Maks027/LabPS/bom.xlsx

Nr. | Name | Package | Quantity | Price
1 | GBJ2510 | GBJ | 1 | 12 | 12
2 | SMA4007 | SMA | 20 | 0.3 | 6
3 | ES3G | SMC | 2 | 3 | 6
 |  |  |  |  | 0
4 | 2SC5200 | 2-21F1A | 1 | 23 | 23
5 | BD140 | TO-126 | 2 | 3 | 6
6 | MMBT5551 | SOT-23 | 10 | 0.6 | 6
 |  |  |  |  | 0
7 | TL431AIDBZR | SOT-23 | 1 | 4 | 4
8 | L7812ABV | TO-220 | 1 | 5 | 5
 |  |  |  |  | 0
9 | 510K | 1206 | 10 | 0.2 | 2
10 | 100K | 1206 | 10 | 0.2 | 2
11 | 39K | 1206 | 10 | 0.2 | 2
12 | 20K | 1206 | 10 | 0.2 | 2
13 | 10K | 1206 | 30 | 0.1 | 3
14 | 9,1K | 1206 | 10 | 0.2 | 2
15 | 4,7K | 1206 | 10 | 0.2 | 2
16 | 2,7K | 1206 | 10 | 0.2 | 2
17 | 2K | 1206 | 10 | 0.2 | 2
18 | 1K | 1206 | 30 | 0.1 | 3
19 | 4,3K | 1W | 2 | 0.5 | 1
20 | 5,6K | 1W | 2 | 0.5 | 1
21 | 0,1R | 2W | 2 | 1 | 2
22 | 0,15R | 2W | 2 | 1 | 2
 |  |  |  |  | 0
23 | 3300uF, 63V | 18х40 | 2 | 18 | 36
24 | 330uF, 16V | 6,3x11 | 4 | 1 | 4
25 | 10uF, 63V | 5x11 | 2 | 0.4 | 0.8
26 | 1uF, 63V | CL21X mini | 3 | 2 | 6
27 | 0,56uF, 63V | CL21 | 2 | 1 | 2
28 | 1nF | 1206 | 10 | 0.3 | 3
29 | 10nF | 1206 | 10 | 0.3 | 3
30 | 100nF | 1206 | 10 | 0.3 | 3
31 | 1uF | 1206 | 10 | 0.5 | 5
 |  |  |  |  | 0
32 | DG306-5,08-03 |  | 2 | 3 | 6
33 | 2K | 3323P | 2 | 4 | 8
 |  |  |  |  | 172.8
