Maks027/LabPS/Schematic_uControl.pdf

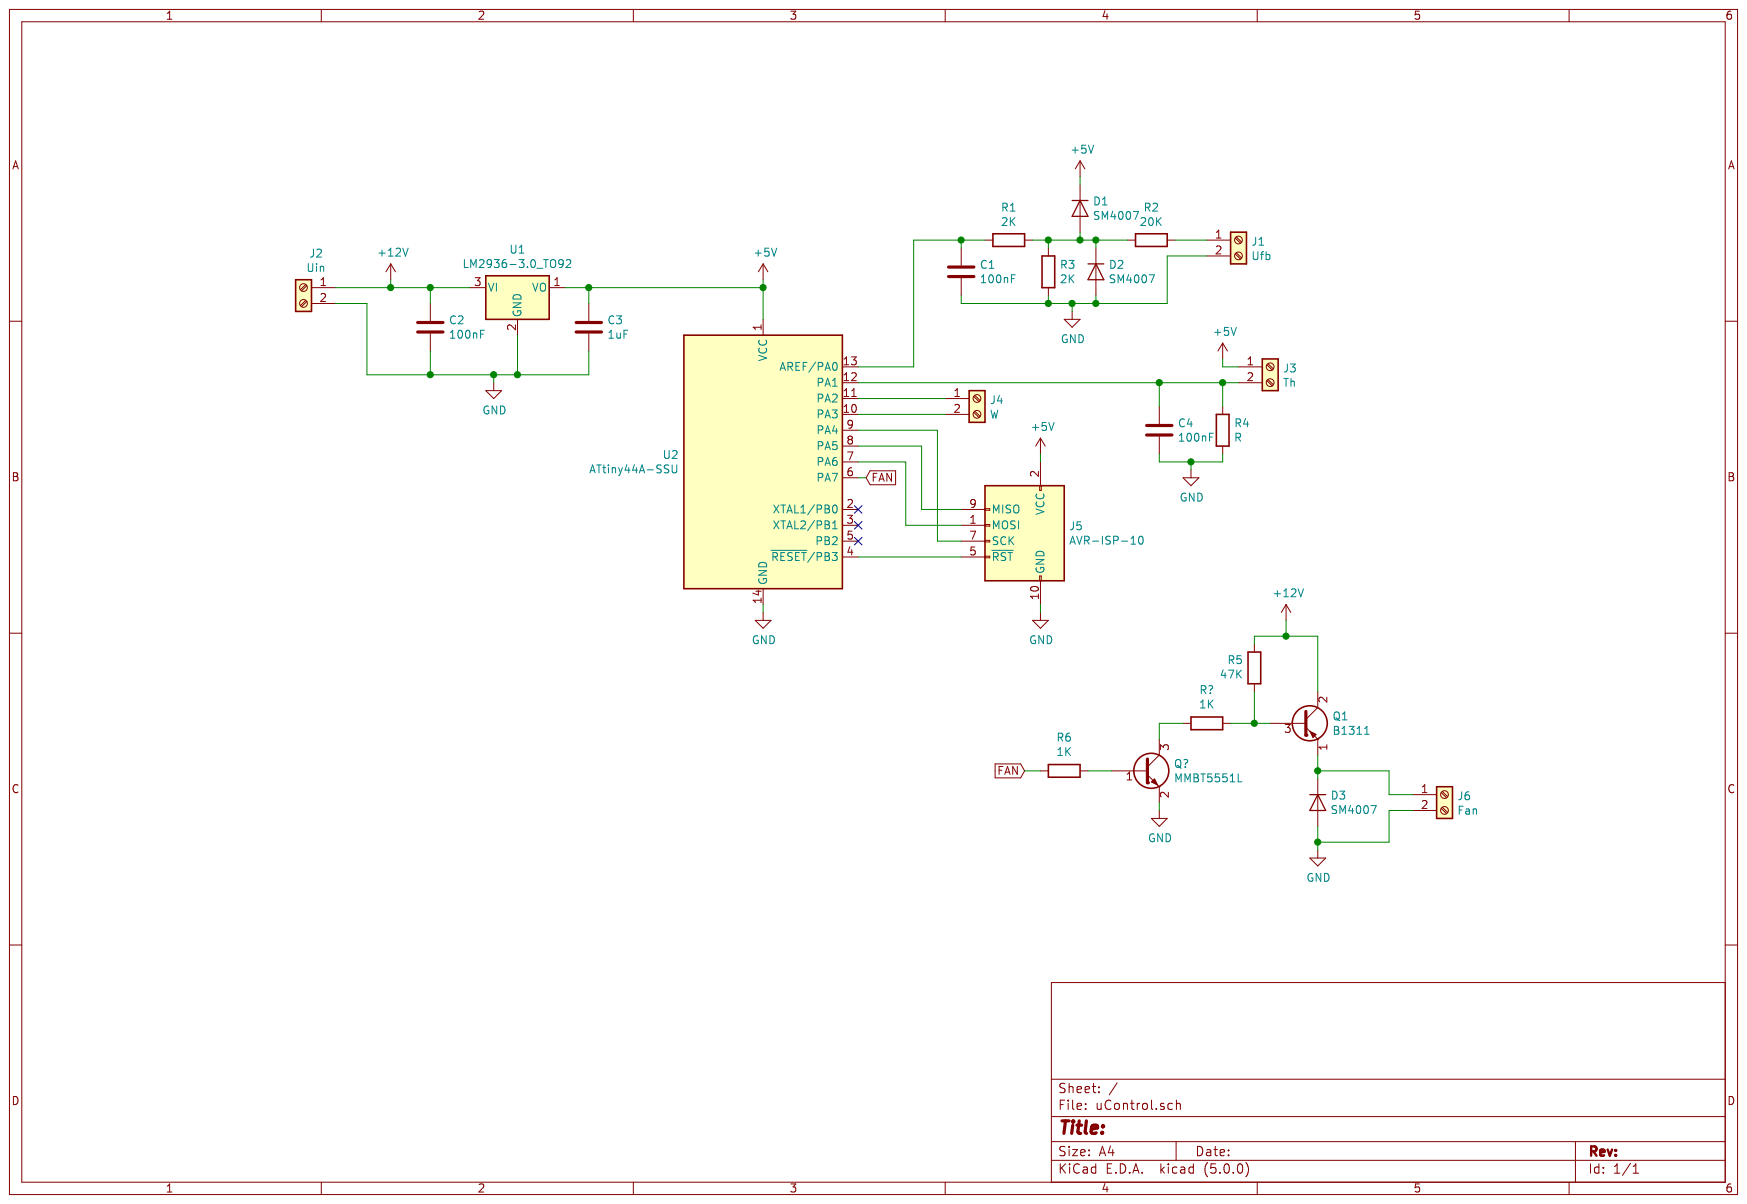
[picture p1: page 1]
