Maks027/LabPS/Schematic_Regulator.pdf

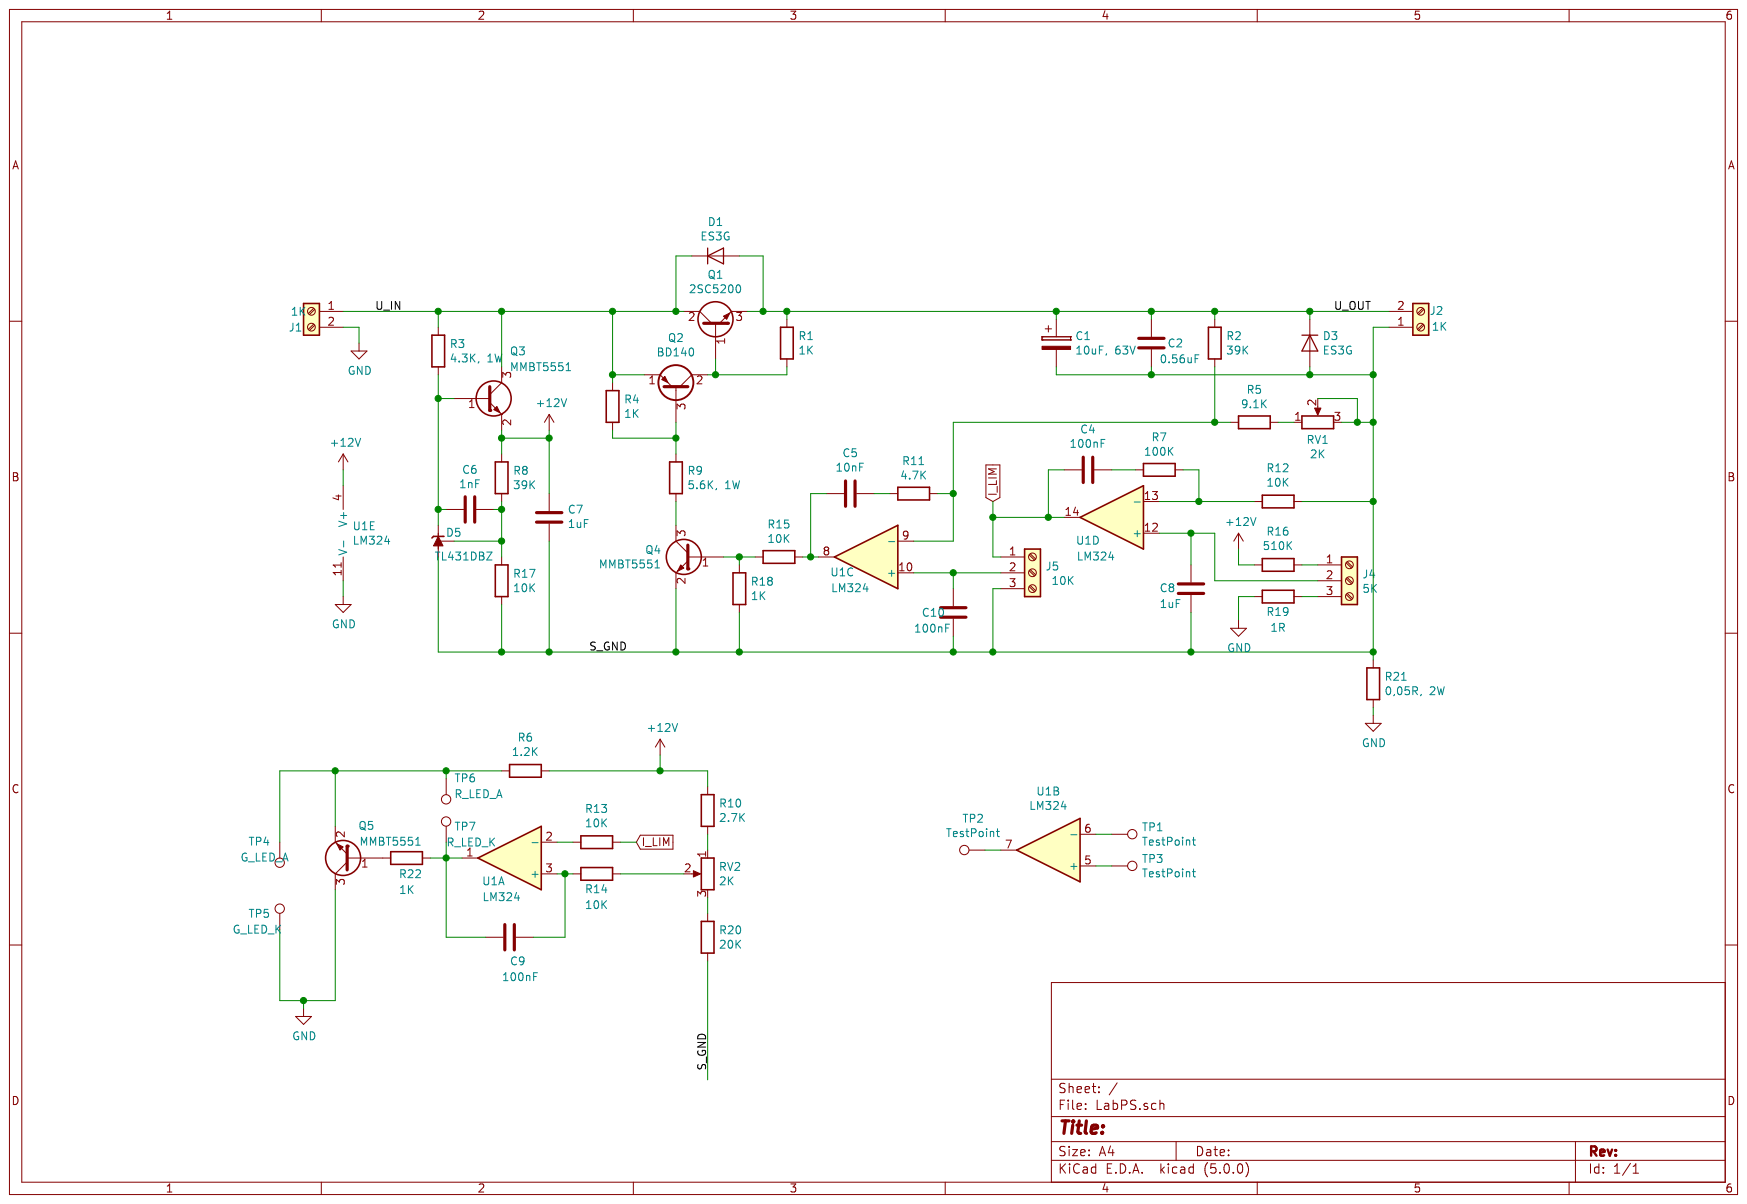
[picture p2: page 1]
