Maks027/LabPS/Schematic_Windings_Commutator.pdf

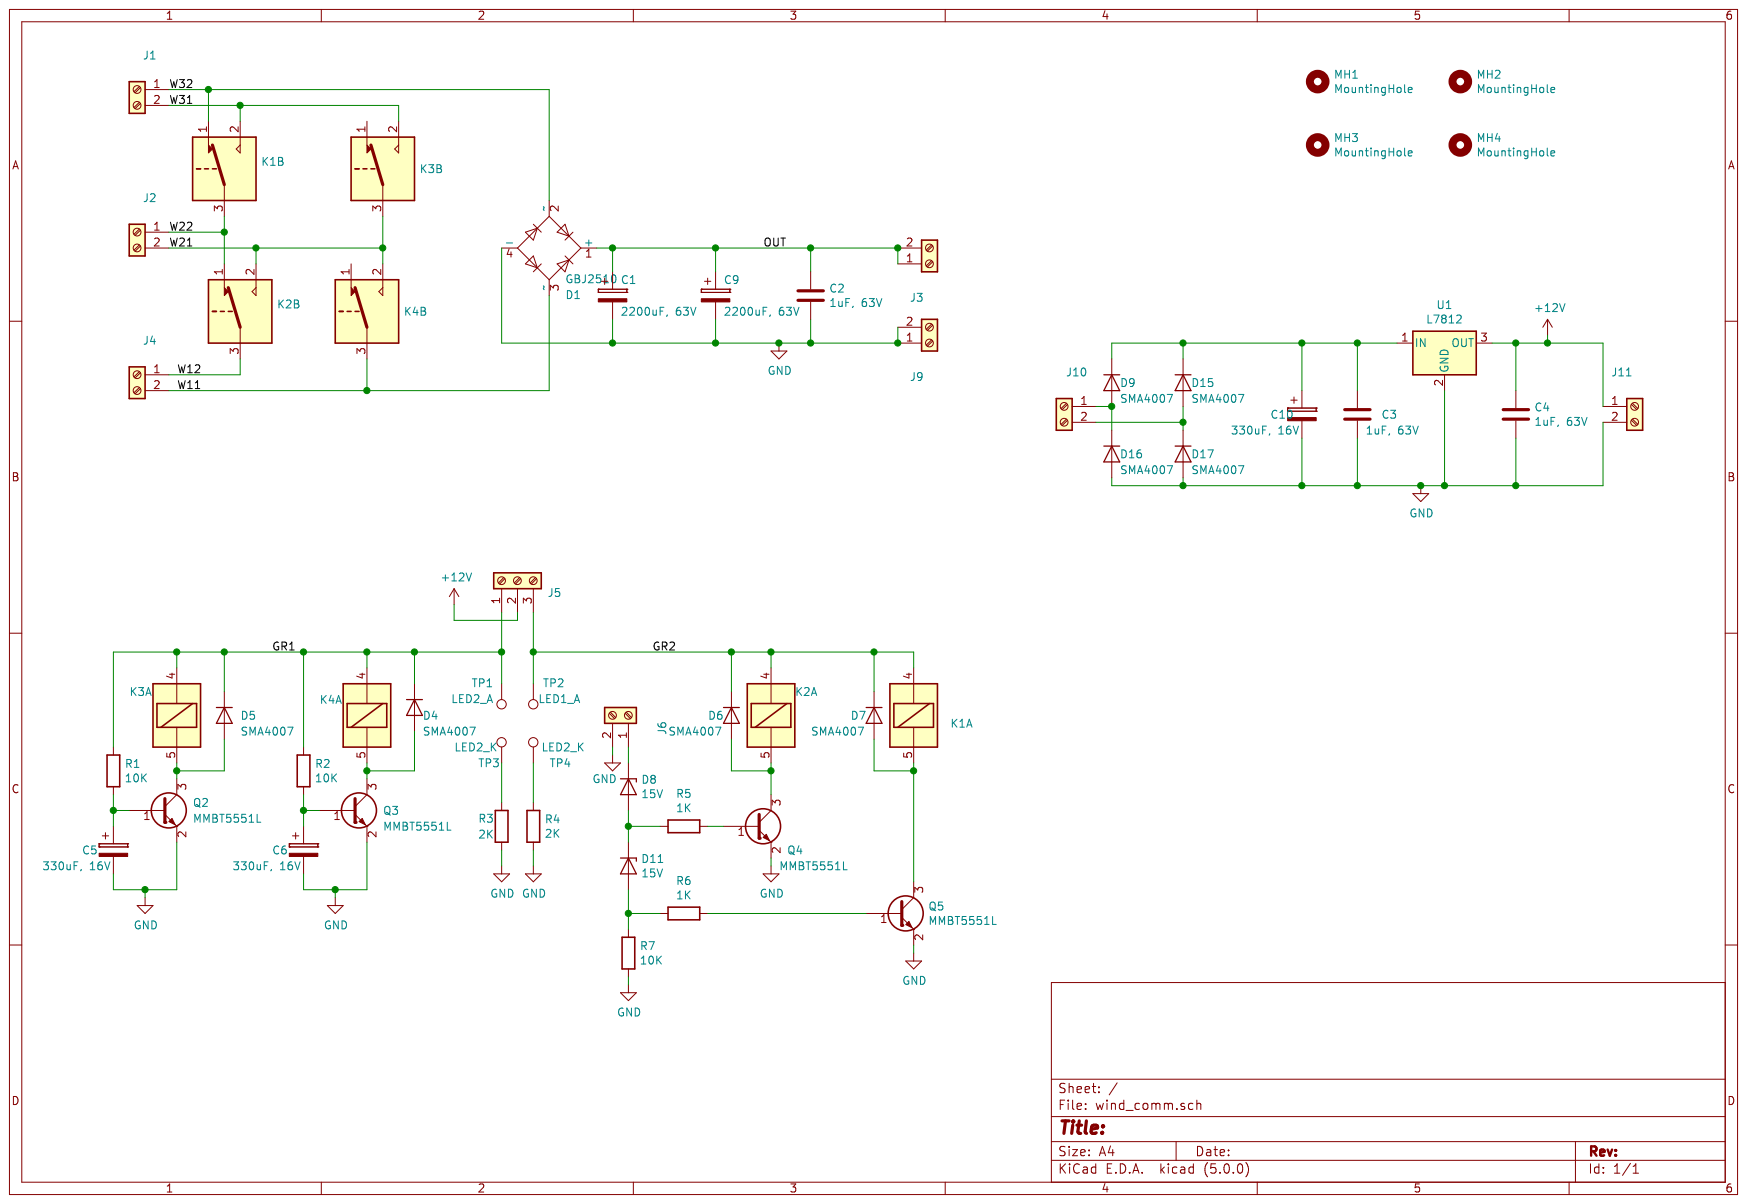
[picture p3: page 1]
