Maks027/LabPS/KiCAD/LabPS/pcb.pdf

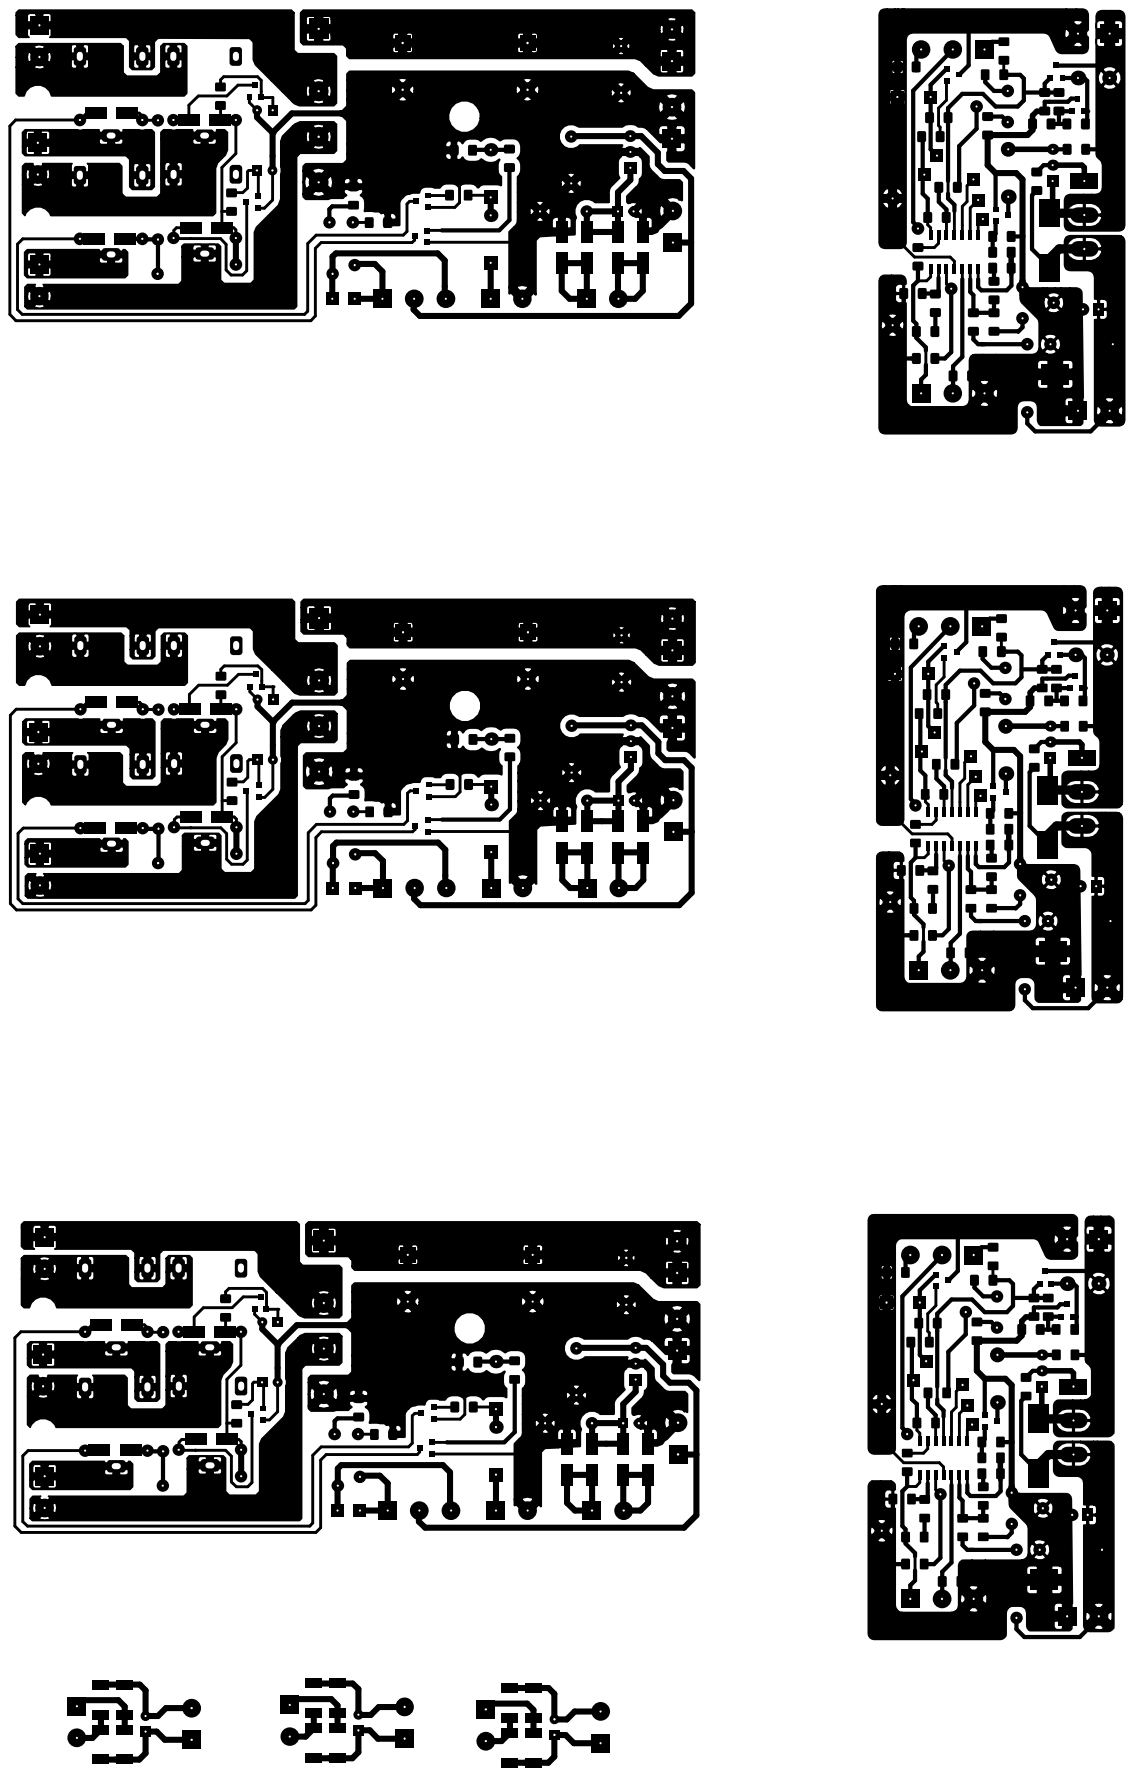
[picture p4: page 1]
