Maks027/LabPS/(list of files, drawings)

Other design files:
KiCAD/wind_comm/wind_comm.dsn
Multisim/LabPS.ms14
