Maks027/LabPS/KiCAD/wind_comm/wind_comm.kicad_pcb

## KiCad design KiCAD/wind_comm/wind_comm.kicad_pcb (2020-04-28)

Schematic: wind_comm.sch

Parts:
C1, C9: 2200uF, 63V; CP_Radial_D18.0mm_P7.50mm
C2, C4: 1uF, 63V; C_Rect_L10.3mm_W7.2mm_P7.50mm_MKS4
C3: 1uF, 63V; C_Rect_L10.3mm_W5.0mm_P7.50mm_MKS4
C5, C6, C10: 330uF, 16V; CP_Radial_D6.3mm_P2.50mm
D1: GBJ2510; Diode_Bridge_Vishay_GBJ
D4, D5, D6, D7, D9, D15, D16, D17: SMA4007; D_SMA_Handsoldering
D8, D11: 15V; D_DO-41_SOD81_P7.62mm_Horizontal
J1, J10: Winding 3; TerminalBlock_bornier-2_P5.08mm
J2: Winding 2; TerminalBlock_bornier-2_P5.08mm
J3: OUT_V; TerminalBlock_bornier-2_P5.08mm
J4: Winding 1; TerminalBlock_bornier-2_P5.08mm
J5: Switch Connector; TerminalBlock_bornier-3_P5.08mm
J6: Volatge Feedback; TerminalBlock_bornier-2_P5.08mm
J9: OUT_GND; TerminalBlock_bornier-2_P5.08mm
J11: 12V_OUT; TerminalBlock_bornier-2_P5.08mm
K1, K2, K3, K4: SRA-12VDC-CL
MH1, MH2, MH3, MH4: MountingHole; MountingHole_3.2mm_M3_ISO7380
Q2, Q3, Q4, Q5: MMBT5551L; SOT-23
R1, R2, R7: 10K; R_1206_3216Metric_Pad1.42x1.75mm_HandSolder
R3, R4: 2K; R_1206_3216Metric_Pad1.42x1.75mm_HandSolder
R5, R6: 1K; R_1206_3216Metric_Pad1.42x1.75mm_HandSolder
TP1: LED2_A; TestPoint_THTPad_2.0x2.0mm_Drill1.0mm
TP2: LED1_A; TestPoint_THTPad_2.0x2.0mm_Drill1.0mm
TP3, TP4: LED2_K; TestPoint_THTPad_D2.0mm_Drill1.0mm
U1: L7812; TO-220-3_Vertical

Connections:
+12V: C4.1, J5.2, J11.1, U1.3 (OUT)
/GR1: D4.1, D5.1, J5.1, K3.4, K4.4, R1.1, R2.1, TP1.1
/GR2: D6.1, D7.1, J5.3, K1.4, K2.4, TP2.1
/OUT: C1.1, C2.1, C9.1, D1.1 (+), J3.1, J3.2
/W11: D1.3 (~~), J4.2, K4.3
/W12: J4.1, K2.3
/W21: J2.2, K2.2, K3.3, K4.2
/W22: J2.1, K1.3, K2.1
/W31: J1.2, K1.2, K3.2
/W32: D1.2 (~~), J1.1, K1.1
GND: C1.2, C2.2, C3.2, C4.2, C5.2, C6.2, C9.2, C10.2, D1.4 (-), D16.2, D17.2, J6.2, J9.1, J9.2, J11.2, Q2.2 (E), Q3.2 (E), Q4.2 (E), Q5.2 (E), R3.2, R4.2, R7.2, U1.2 (GND)
unnamed: C5.1, Q2.1 (B), R1.2
unnamed: C6.1, Q3.1 (B), R2.2
unnamed: C3.1, C10.1, D9.1, D15.1, U1.1 (IN)
unnamed: D4.2, K4.5, Q3.3 (C)
unnamed: D5.2, K3.5, Q2.3 (C)
unnamed: D6.2, K2.5, Q4.3 (C)
unnamed: D7.2, K1.5, Q5.3 (C)
unnamed: D8.1, J6.1
unnamed: D8.2, D11.1, R5.2
unnamed: D11.2, R6.2, R7.1
unnamed: D15.2, D17.1, J10.2
unnamed: D9.2, D16.1, J10.1
unnamed: Q4.1 (B), R5.1
unnamed: Q5.1 (B), R6.1
unnamed: R3.1, TP3.1
unnamed: R4.1, TP4.1

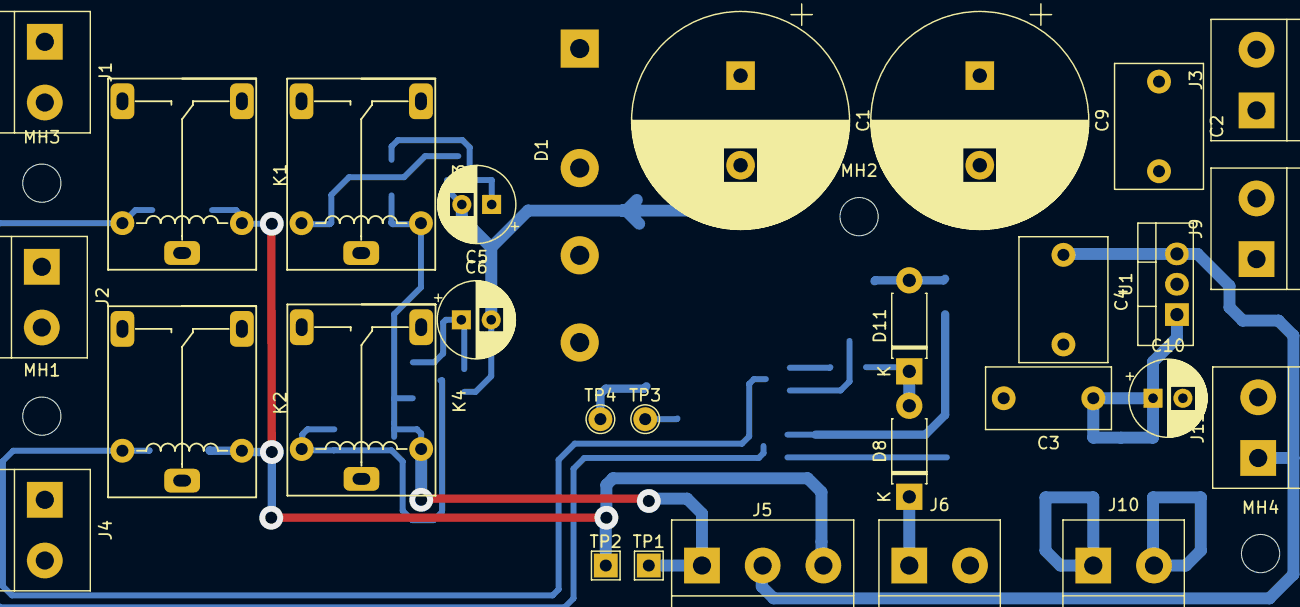
[picture p5: board wind_comm.kicad_pcb from above]

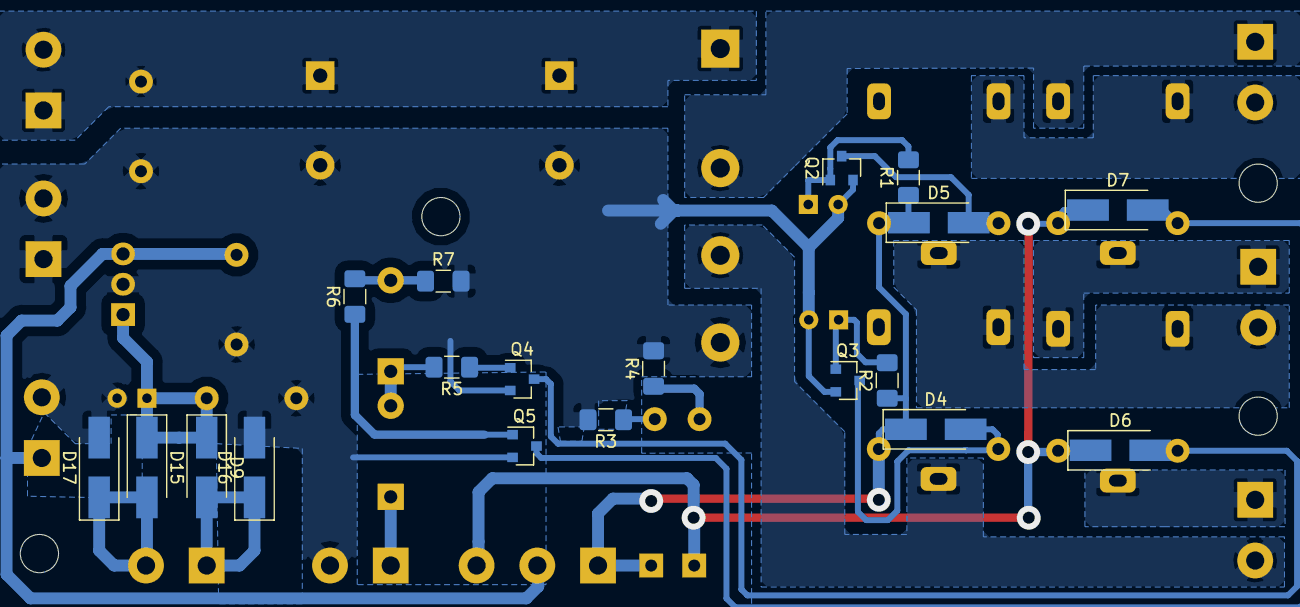
[picture p6: board wind_comm.kicad_pcb from below]

Board: 2 copper layers, 52 parts (19 on the bottom side), 27 nets.
