Maks027/LabPS/KiCAD/LabPS/LabPS/LabPS.kicad_pcb

## KiCad design KiCAD/LabPS/LabPS/LabPS.kicad_pcb (2020-04-28)

Schematic: LabPS.sch

Parts:
C1: 10uF, 63V; CP_Radial_D5.0mm_P2.50mm
C2: 0.56uF; C_Rect_L13.0mm_W5.0mm_P10.00mm_FKS3_FKP3_MKS4
C4, C9, C10: 100nF; C_1206_3216Metric_Pad1.42x1.75mm_HandSolder
C5: 10nF; C_1206_3216Metric_Pad1.42x1.75mm_HandSolder
C6: 1nF; C_1206_3216Metric_Pad1.42x1.75mm_HandSolder
C7, C8: 1uF; C_1206_3216Metric_Pad1.42x1.75mm_HandSolder
D1, D3: ES3G; D_SMC_Handsoldering
D5: TL431DBZ; SOT-23
J1, J2: 1K; TerminalBlock_bornier-2_P5.08mm
J4: 5K; TerminalBlock_bornier-3_P5.08mm
J5: 10K; TerminalBlock_bornier-3_P5.08mm
Q1: 2SC5200; TO-3P-3_Vertical
Q2: BD140; TO-126-3_Vertical
Q3, Q4, Q5: MMBT5551; SOT-23
R1, R4, R18, R22: 1K; R_1206_3216Metric_Pad1.42x1.75mm_HandSolder
R2, R8: 39K; R_1206_3216Metric_Pad1.42x1.75mm_HandSolder
R3: 4.3K, 1W; R_Axial_DIN0414_L11.9mm_D4.5mm_P5.08mm_Vertical
R5: 9.1K; R_1206_3216Metric_Pad1.42x1.75mm_HandSolder
R6: 1.2K; R_1206_3216Metric_Pad1.42x1.75mm_HandSolder
R7: 100K; R_1206_3216Metric_Pad1.42x1.75mm_HandSolder
R9: 5.6K, 1W; R_Axial_DIN0414_L11.9mm_D4.5mm_P7.62mm_Vertical
R10: 2.7K; R_1206_3216Metric_Pad1.42x1.75mm_HandSolder
R11: 4.7K; R_1206_3216Metric_Pad1.42x1.75mm_HandSolder
R12, R13, R14, R15, R17: 10K; R_1206_3216Metric_Pad1.42x1.75mm_HandSolder
R16: 510K; R_1206_3216Metric_Pad1.42x1.75mm_HandSolder
R19: 1R; R_1206_3216Metric_Pad1.42x1.75mm_HandSolder
R20: 20K; R_1206_3216Metric_Pad1.42x1.75mm_HandSolder
R21: 0,05R, 2W; R_Axial_DIN0516_L15.5mm_D5.0mm_P20.32mm_Horizontal
RV1, RV2: 2K; Potentiometer_Piher_PT-6-V_Vertical
TP1, TP2, TP3: TestPoint; TestPoint_THTPad_2.0x2.0mm_Drill1.0mm
TP4: G_LED_A; TestPoint_THTPad_2.0x2.0mm_Drill1.0mm
TP5: G_LED_K; TestPoint_THTPad_2.0x2.0mm_Drill1.0mm
TP6: R_LED_A; TestPoint_THTPad_2.0x2.0mm_Drill1.0mm
TP7: R_LED_K; TestPoint_THTPad_2.0x2.0mm_Drill1.0mm
U1: LM324

Connections:
+12V: C7.2, Q3.2 (E), R6.2, R8.1, R10.1, R16.1, U1.4 (V+)
/S_GND: C1.2, C2.2, C7.1, C8.1, C10.2, D3.2, D5.3, J2.1, J5.3, Q4.2 (E), R12.2, R17.2, R18.2, R20.2, R21.1, RV1.2, RV1.3
/U_IN: D1.1, J1.1, Q1.2, Q2.1, Q3.3 (C), R3.1, R4.1
/U_OUT: C1.1, C2.1, D1.2, D3.1, J2.2, Q1.3, R1.1, R2.1
GND: J1.2, Q5.3 (C), R19.1, R21.2, TP5.1, U1.11 (V-)
I_LIM: C4.1, J5.1, R13.2, U1.14
unnamed: C4.2, R7.2
unnamed: C5.1, R15.1, U1.8
unnamed: C5.2, R11.2
unnamed: C6.1, D5.2, R8.2, R17.1
unnamed: C6.2, D5.1, Q3.1 (B), R3.2
unnamed: C8.2, J4.2, U1.12 (+)
unnamed: C9.1, R14.1, U1.3 (+)
unnamed: C9.2, R22.1, TP7.1, U1.1
unnamed: C10.1, J5.2, U1.10 (+)
unnamed: J4.1, R16.2
unnamed: J4.3, R19.2
unnamed: Q1.1, Q2.2, R1.2
unnamed: Q2.3, R4.2, R9.1
unnamed: Q4.1 (B), R15.2, R18.1
unnamed: Q4.3 (C), R9.2
unnamed: Q5.1 (B), R22.2
unnamed: Q5.2 (E), R6.1, TP4.1, TP6.1
unnamed: R5.1, RV1.1
unnamed: R10.2, RV2.1
unnamed: R2.2, R5.2, R11.1, U1.9 (-)
unnamed: R7.1, R12.1, U1.13 (-)
unnamed: R13.1, U1.2 (-)
unnamed: R14.2, RV2.2
unnamed: R20.1, RV2.3
unnamed: TP1.1, U1.6 (-)
unnamed: TP2.1, U1.7
unnamed: TP3.1, U1.5 (+)

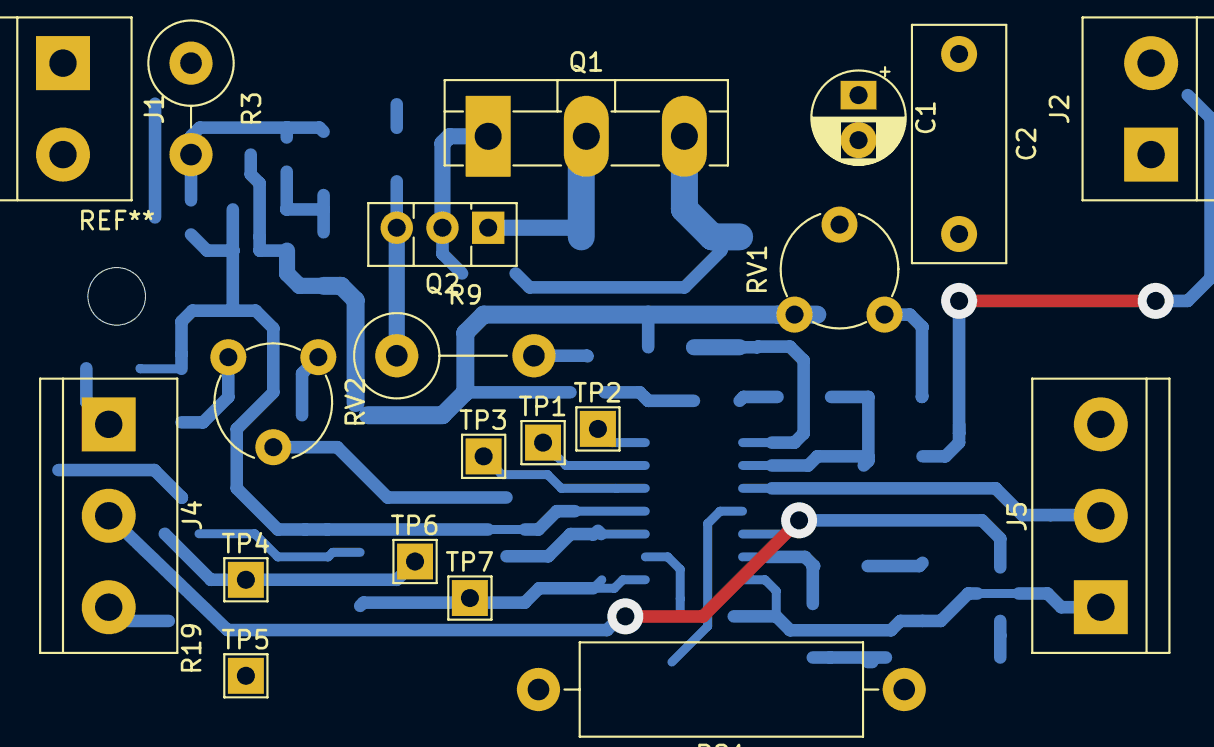
[picture p7: board LabPS.kicad_pcb from above]

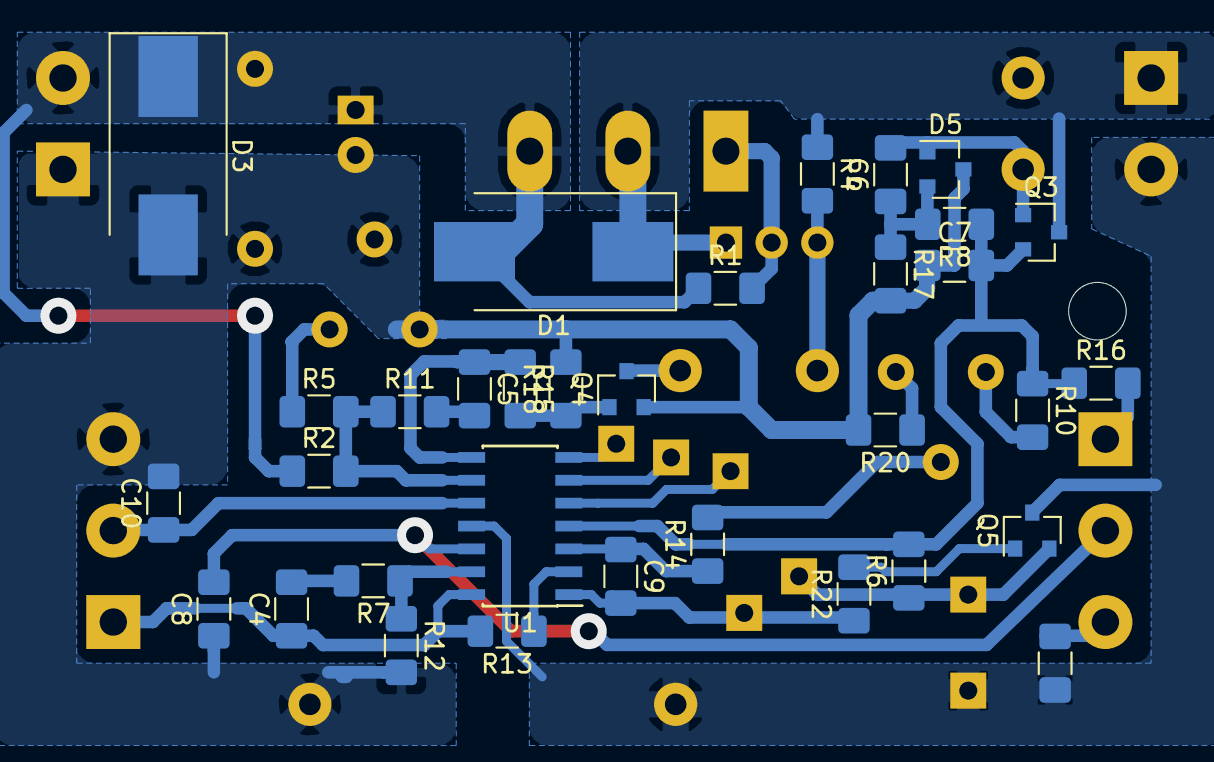
[picture p8: board LabPS.kicad_pcb from below]

Board: 2 copper layers, 53 parts (33 on the bottom side), 33 nets.
