Maks027/LabPS/KiCAD/rectifier/rectifier/rectifier.kicad_pcb

## KiCad design KiCAD/rectifier/rectifier/rectifier.kicad_pcb (2020-04-28)

Schematic: rectifier.sch

Parts:
C1: 330uF, 16V; CP_Radial_D6.3mm_P2.50mm
D1, D2, D3, D4: SM4007; D_MELF
J1, J2: Screw_Terminal_01x02; TerminalBlock_bornier-2_P5.08mm

Connections:
unnamed: C1.1, D1.1 (K), D2.1 (K), J2.1
unnamed: C1.2, D3.2 (A), D4.2 (A), J2.2
unnamed: D1.2 (A), D3.1 (K), J1.1
unnamed: D2.2 (A), D4.1 (K), J1.2

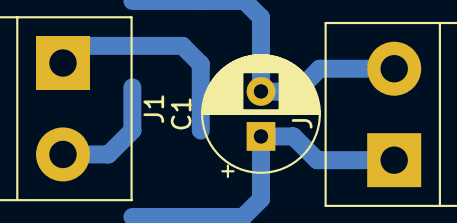
[picture p9: board rectifier.kicad_pcb from above]

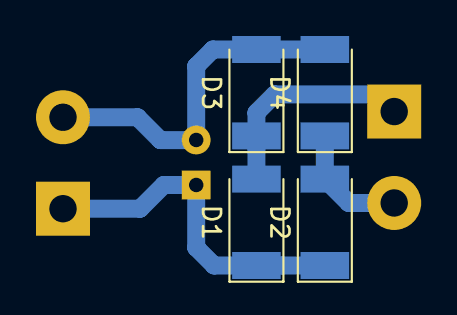
[picture p10: board rectifier.kicad_pcb from below]

Board: 2 copper layers, 7 parts (4 on the bottom side), 4 nets.
